DarqSh/kicad_function_generator/falstad_sims/final_10-100Hz_design_v5.txt

<cir f="1" ts="0.00019999999999999998" ic="1.9265835257097934" cb="59" pb="43" vr="5" mts="5e-11">
  <a x="208 96 288 96" f="8" ma="12" mi="-12" ga="100000"/>
  <a x="416 240 496 240" f="8" ma="12" mi="-12" ga="100000"/>
  <c x="272 528 336 528" f="0" c="0.0000015" iv="0.001" sr="0" vd="-1.0300397190273567"/>
  <c x="-16 352 -16 416" f="0" c="0.0000015" iv="0.001" sr="0" vd="0.4276747453221634"/>
  <r x="368 528 464 528" f="0" r="3300"/>
  <r x="48 80 112 80" f="0" r="100"/>
  <r x="224 0 288 0" f="0" r="3300"/>
  <r x="320 96 384 96" f="0" r="3300"/>
  <r x="432 96 496 96" f="0" r="3300"/>
  <r x="416 16 496 16" f="0" r="66000"/>
  <d x="560 16 656 16" f="0" mo="default"/>
  <d x="656 -48 560 -48" f="0" mo="default"/>
  <pt x="-80 80 -16 80" f="1" ma="40000" po="0.005" sl="R_freq_change"/>
  <pt x="560 96 656 96" f="1" ma="1000" po="0.7376" sl="R_feedback_tune"/>
  <g x="176 144 176 192" f="0"/>
  <g x="-16 416 -16 432" f="0"/>
  <w x="-48 64 -48 32" f="0"/>
  <w x="-48 32 16 32" f="0"/>
  <w x="16 32 16 80" f="0"/>
  <w x="-16 80 16 80" f="0"/>
  <w x="16 80 48 80" f="0"/>
  <w x="112 80 176 80" f="0"/>
  <w x="208 112 176 112" f="0"/>
  <w x="176 112 176 144" f="0"/>
  <w x="336 256 416 256" f="0"/>
  <w x="288 96 304 96" f="0"/>
  <w x="384 96 416 96" f="0"/>
  <w x="416 96 432 96" f="0"/>
  <w x="416 224 416 96" f="0"/>
  <w x="288 0 304 0" f="0"/>
  <w x="304 96 320 96" f="0"/>
  <w x="304 0 304 96" f="0"/>
  <w x="224 0 176 0" f="0"/>
  <w x="176 80 208 80" f="0"/>
  <w x="176 0 176 80" f="0"/>
  <w x="416 16 416 96" f="0"/>
  <w x="496 16 512 16" f="0"/>
  <w x="560 -48 512 -48" f="0"/>
  <w x="512 16 560 16" f="0"/>
  <w x="512 -48 512 16" f="0"/>
  <w x="496 96 528 96" f="0"/>
  <w x="656 -48 656 16" f="0"/>
  <w x="656 16 656 96" f="0"/>
  <w x="496 240 656 240" f="0"/>
  <w x="656 240 656 96" f="0"/>
  <w x="-80 80 -80 256" f="0"/>
  <w x="-80 256 -16 256" f="0"/>
  <w x="272 528 -80 528" f="0"/>
  <w x="-80 528 -80 256" f="0"/>
  <w x="336 528 368 528" f="0"/>
  <w x="656 528 656 240" f="0"/>
  <w x="608 80 608 48" f="0"/>
  <w x="608 48 528 48" f="0"/>
  <w x="528 96 560 96" f="0"/>
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
  <a x="1312 288 1424 288" f="8" ma="12" mi="-12" ga="100000"/>
  <g x="1280 320 1280 352" f="0"/>
  <w x="1312 304 1280 304" f="0"/>
  <w x="1280 304 1280 320" f="0"/>
  <w x="1264 272 1312 272" f="0"/>
  <c x="1312 192 1440 192" f="0" c="0.000002" iv="0.001" sr="0" vd="-0.8287330604732464"/>
  <r x="1312 128 1440 128" f="0" r="330000"/>
  <w x="1312 272 1312 192" f="0"/>
  <w x="1312 192 1312 128" f="0"/>
  <w x="1440 128 1440 192" f="0"/>
  <w x="1440 192 1440 288" f="0"/>
  <w x="1424 288 1440 288" f="0"/>
  <a x="928 272 1056 272" f="9" ma="12" mi="-12" ga="100000"/>
  <r x="464 528 656 528" f="0" r="50"/>
  <r x="-16 352 -16 256" f="0" r="50"/>
  <Scope x="1600 -400 2048 -192" f="0">
    <o en="43" sp="8" f="x3" p="-1">
      <p v="0" sc="20"/>
      <p v="3" sc="0.0125"/>
    </o>
  </Scope>
  <w x="-16 256 336 256" f="0"/>
  <Scope x="976 -192 1408 32" f="0">
    <o en="65" sp="1" f="x3" p="-1">
      <p v="0" sc="20"/>
      <p v="3" sc="0.025"/>
    </o>
  </Scope>
  <a x="736 256 832 256" f="8" ma="12" mi="-12" ga="100000"/>
  <w x="656 240 736 240" f="0"/>
  <w x="736 272 736 368" f="0"/>
  <w x="736 368 848 368" f="0"/>
  <r x="848 256 848 368" f="0" r="330000"/>
  <r x="848 368 848 448" f="0" r="33000"/>
  <g x="848 448 848 496" f="0"/>
  <w x="832 256 848 256" f="0"/>
  <w x="928 256 832 256" f="0"/>
  <w x="928 288 928 352" f="0"/>
  <w x="928 352 1056 352" f="0"/>
  <w x="1056 352 1056 272" f="0"/>
  <w x="1440 288 1472 288" f="0"/>
  <c x="1600 304 1696 304" f="0" c="0.000002" iv="0.001" sr="0" vd="-1.2801939105544364"/>
  <w x="1696 304 1696 320" f="0"/>
  <pt x="1696 320 1696 416" f="1" ma="66000" po="0.06440000000000001" sl="triangle_filter_tune"/>
  <g x="1696 416 1696 448" f="0"/>
  <w x="1712 368 1760 368" f="0"/>
  <w x="1760 368 1760 416" f="0"/>
  <w x="1760 416 1696 416" f="0"/>
  <w x="1600 304 1600 384" f="0"/>
  <w x="1472 320 1472 384" f="0"/>
  <a x="1472 304 1600 304" f="9" ma="12" mi="-12" ga="100000"/>
  <w x="1472 384 1600 384" f="0"/>
  <w x="1792 304 1696 304" f="0"/>
  <Scope x="1472 -144 2176 256" f="0">
    <o en="97" sp="2" f="x30403" p="-1">
      <p v="0" sc="10"/>
      <p v="3" sc="0.00009765625"/>
    </o>
  </Scope>
  <w x="1760 576 1808 576" f="0"/>
  <pt x="1744 528 1744 624" f="1" ma="100000" po="0.35150000000000003" sl="DC_choose"/>
  <g x="1616 576 1568 576" f="0"/>
  <v x="1616 576 1616 480" f="16" wf="0" maxv="12"/>
  <v x="1616 672 1616 576" f="16" wf="0" maxv="12"/>
  <w x="1616 480 1744 480" f="0"/>
  <w x="1744 496 1744 528" f="0"/>
  <w x="1744 624 1744 672" f="0"/>
  <w x="1616 672 1744 672" f="0"/>
  <w x="1856 672 1984 672" f="0"/>
  <a x="1856 592 1984 592" f="9" ma="12" mi="-12" ga="100000"/>
  <w x="1856 608 1856 672" f="0"/>
  <w x="1984 592 1984 672" f="0"/>
  <w x="1808 576 1856 576" f="0"/>
  <w x="1984 592 2032 592" f="0"/>
  <r x="2032 592 2144 592" f="0" r="5000"/>
  <w x="1792 400 1920 400" f="0"/>
  <a x="1792 320 1920 320" f="9" ma="12" mi="-12" ga="100000"/>
  <w x="1792 336 1792 352" f="0"/>
  <w x="1920 320 1920 400" f="0"/>
  <w x="1792 352 1792 400" f="0"/>
  <r x="1920 320 2032 320" f="0" r="2500"/>
  <a x="2208 336 2320 336" f="8" ma="12" mi="-12" ga="100000"/>
  <g x="2192 368 2192 400" f="0"/>
  <w x="2192 368 2192 352" f="0"/>
  <w x="2192 352 2208 352" f="0"/>
  <w x="2032 320 2048 320" f="0"/>
  <w x="2144 320 2208 320" f="0"/>
  <w x="2144 592 2144 352" f="0"/>
  <w x="2208 320 2208 256" f="0"/>
  <r x="2208 256 2320 256" f="0" r="5000"/>
  <w x="2320 256 2320 336" f="0"/>
  <Scope x="2240 -80 2720 160" f="0">
    <o en="130" sp="1" f="x20003" p="-1">
      <p v="0" sc="20"/>
      <p v="3" sc="0.003125"/>
    </o>
  </Scope>
  <pt x="1168 272 1264 272" f="1" ma="20000" po="0.0347" sl="triangle_gain"/>
  <r x="1056 272 1152 272" f="0" r="3000"/>
  <w x="1216 256 1216 224" f="0"/>
  <w x="1216 224 1264 224" f="0"/>
  <w x="1264 224 1264 272" f="0"/>
  <pt x="2048 320 2144 320" f="1" ma="50000" po="0.0545" sl="final_output_gain"/>
  <w x="1744 480 1744 496" f="0"/>
  <w x="2144 352 2144 320" f="0"/>
  <w x="2096 304 2096 272" f="0"/>
  <w x="2096 272 2144 272" f="0"/>
  <w x="2144 272 2144 320" f="0"/>
  <r x="1056 224 1152 224" f="0" r="3000"/>
  <w x="1056 272 1056 224" f="0"/>
  <w x="1152 272 1168 272" f="0"/>
  <w x="1152 224 1152 272" f="0"/>
  <o en="43" sp="2" f="x1040a" p="0">
    <p v="0" sc="15.549997616011646"/>
    <p v="3" sc="0.0001"/>
  </o>
  <o en="81" sp="2" f="x28003" p="1">
    <p v="0" sc="20"/>
    <p v="3" sc="0.00009765625"/>
  </o>
</cir>
