DarqSh/kicad_function_generator/function_generator.csv

Reference | Qty | Value | DNP | Exclude from BOM | Exclude from Board | Footprint | Datasheet
C1,C5 | 2 | 1.5nF |  |  |  | capacitor_mine_1p5n:FKP2L011501G00HF00
C2,C6 | 2 | 15nF |  |  |  | capacitor_mine_15n:FKP2F021501L00HSSD
C3,C7 | 2 | 0.15uF |  |  |  | capacitor_mine_150n:R75IF315050H3J
C4,C8 | 2 | 1.5uF |  |  |  | capacitor_mine_1p5u:R75IN415050H4J
C9,C14 | 2 | 22nF |  |  |  | capacitor_mine_22n:B32620__10_x_4_
C10,C16 | 2 | 2.2uF |  |  |  | capacitor_mine_2p2u:890443325010CS
C11,C13 | 2 | 0.22uF |  |  |  | capacitor_mine_220n:B32672__18_x_9_
C12,C15 | 2 | 2.2nF |  |  |  | capacitor_mine_2p2n:B32671L__13_x_5_
C17 | 1 | 22uF |  |  |  | capacitor_mine_22u:CAPAE660X550N
C18,C27,C29,C33,C34,C35,C36,C39,C40,C41,C42,C43,C44,C45,C46,C47,C48 | 17 | 100nF |  |  |  | Capacitor_SMD:C_0805_2012Metric_Pad1.18x1.45mm_HandSolder
C19 | 1 | 47nF |  |  |  | Capacitor_SMD:C_0805_2012Metric_Pad1.18x1.45mm_HandSolder
C20,C22,C25 | 3 | 1uF |  |  |  | Capacitor_SMD:C_0805_2012Metric_Pad1.18x1.45mm_HandSolder
C21 | 1 | 68nF |  |  |  | Capacitor_SMD:C_0805_2012Metric_Pad1.18x1.45mm_HandSolder
C23,C24 | 2 | 10uF |  |  |  | Capacitor_SMD:C_1206_3216Metric_Pad1.33x1.80mm_HandSolder
C26,C28,C30,C31,C32,C37,C38 | 7 | 2.2uF |  |  |  | Capacitor_SMD:C_1206_3216Metric_Pad1.33x1.80mm_HandSolder
D1,D2 | 2 | D |  |  |  | Diode_SMD:D_SOD-123
D3,D7,D8,D9,D10 | 5 | SBA240CH-AU_R1_007A1 |  |  |  | schottky_mine:SBA240CHAU_R1_007A1 | https://www.panjit.com.tw/upload/datasheet/SBA220CH-AU_SERIES.pdf
D4,D5 | 2 | DFLS240-7 |  |  |  | schottky_mine_lowcapacitance:POWERDI123 | https://www.diodes.com//assets/Datasheets/DFLS240.pdf
D6 | 1 | LED |  |  |  | LED_SMD:LED_0805_2012Metric_Pad1.15x1.40mm_HandSolder
F1 | 1 | SF-0402S100M-2 |  |  |  | fuse_my:FUSC1005X61N | https://www.bourns.com/docs/product-datasheets/sf-0402s-m.pdf?sfvrsn=c5e676f6_19
IC1,IC3 | 2 | NE5532AD8R2G |  |  |  | ne5532_onsemi:SOIC127P600X175-8N | https://www.onsemi.com/pub/Collateral/NE5532-D.PDF
IC2,IC4 | 2 | TMUX4052DYYRQ1 |  |  |  | mux_1-to-4:SOP50P326X110-16N | https://www.ti.com/lit/ds/symlink/tmux4052-q1.pdf?ts=1771772113479
IC5 | 1 | TLV1871DDFR |  |  |  | comparator_for_square:SOT65P280X110-8N | https://www.ti.com/product/TLV1871/part-details/TLV1871DDFR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
IC8 | 1 | ADP5070AREZ |  |  |  | adp5070:SOP65P640X120-21N | https://www.analog.com/media/en/technical-documentation/data-sheets/adp5070.pdf
IC9,IC11 | 2 | ADP7142AUJZ-R7 |  |  |  | ldo_positive:SOT95P280X100-5N | https://www.analog.com/ADP7142/datasheet
IC10,IC12 | 2 | ADP7182AUJZ-R7 |  |  |  | ldo_negative:SOT95P280X100-5N | http://www.analog.com/media/en/technical-documentation/data-sheets/ADP7182.pdf
IC13 | 1 | OPA1656IDR |  |  |  | opa1656_mine:SOIC127P600X175-8N | http://www.ti.com/lit/gpn/OPA1656
J1 | 1 | barrel_jack |  |  |  | barrel_jack_connector:694106301002 | https://www.we-online.com/catalog/datasheet/694106301002.pdf
J2,J3 | 2 | 571-0500 |  |  |  | banana_socket:5710500 | https://componentsearchengine.com/Datasheets/1/571-0500.pdf
L1 | 1 | 6.8uH |  |  |  | inductor_mine_positive:XAL6060682MEC
L2 | 1 | 15uH |  |  |  | inductor_mine_negative:XAL6060153MEC
R1,R4,R5,R6 | 4 | 3.3k |  |  |  | Resistor_SMD:R_0805_2012Metric_Pad1.20x1.40mm_HandSolder
R2,R14,R32,R33,R35 | 5 | 10k |  |  |  | Resistor_SMD:R_0805_2012Metric_Pad1.20x1.40mm_HandSolder
R3 | 1 | 300 |  |  |  | Resistor_SMD:R_0805_2012Metric_Pad1.20x1.40mm_HandSolder
R7 | 1 | 64.9k |  |  |  | Resistor_SMD:R_0805_2012Metric_Pad1.20x1.40mm_HandSolder
R8,R34 | 2 | 5k |  |  |  | Resistor_SMD:R_0805_2012Metric_Pad1.20x1.40mm_HandSolder
R9,R10 | 2 | 3.9k |  |  |  | Resistor_SMD:R_0805_2012Metric_Pad1.20x1.40mm_HandSolder
R11,R19,R29 | 3 | 100k |  |  |  | Resistor_SMD:R_0805_2012Metric_Pad1.20x1.40mm_HandSolder
R12 | 1 | 330k |  |  |  | Resistor_SMD:R_0805_2012Metric_Pad1.20x1.40mm_HandSolder
R13,R16,R27 | 3 | 15k |  |  |  | Resistor_SMD:R_0805_2012Metric_Pad1.20x1.40mm_HandSolder
R15 | 1 | 12k |  |  |  | Resistor_SMD:R_0805_2012Metric_Pad1.20x1.40mm_HandSolder
R17 | 1 | 2.15M |  |  |  | Resistor_SMD:R_0805_2012Metric_Pad1.20x1.40mm_HandSolder
R18 | 1 | 113k |  |  |  | Resistor_SMD:R_0805_2012Metric_Pad1.20x1.40mm_HandSolder
R20 | 1 | 2.1M |  |  |  | Resistor_SMD:R_0805_2012Metric_Pad1.20x1.40mm_HandSolder
R21,R24 | 2 | 52.3k |  |  |  | Resistor_SMD:R_0805_2012Metric_Pad1.20x1.40mm_HandSolder
R22,R23,R25,R26 | 4 | 4.64k |  |  |  | Resistor_SMD:R_0805_2012Metric_Pad1.20x1.40mm_HandSolder
R28 | 1 | 102k |  |  |  | Resistor_SMD:R_0805_2012Metric_Pad1.20x1.40mm_HandSolder
R30,R31 | 2 | 11.5k |  |  |  | Resistor_SMD:R_0805_2012Metric_Pad1.20x1.40mm_HandSolder
S1,S2 | 2 | ASLB1470 |  |  |  | slide_switch_sp4t:ASLB1470 | https://www.apem.com/idec-apem/en_US/medias/APEM-Miniature-slide-switches-ASLB.pdf
VR1,VR6 | 2 | 100k |  |  |  | pot_100k_linear:PTN091V100115K1B | https://www.sameskydevices.com/product/resource/ptn09x.pdf
VR2 | 1 | 1k |  |  |  | pot_1k_feedbacktune:PTN091V01115K1B | https://www.sameskydevices.com/product/resource/ptn09x.pdf
VR3 | 1 | 20k |  |  |  | pot_20k:PTN091V20115K1B | https://www.sameskydevices.com/product/resource/ptn09x.pdf
VR4 | 1 | 100k_log |  |  |  | pot_100k_log:PTN091V100115K1A | https://www.sameskydevices.com/product/resource/ptn09x.pdf
VR5 | 1 | 20k dual-gang |  |  |  | pot_20k_dualgang:P140KH1Y20AR20K | https://www.ttelectronics.com/TTElectronics/media/ProductFiles/Datasheet/P140.pdf
