DarqSh/kicad_function_generator/production/bom.csv

Designator | Footprint | Quantity | Value | LCSC Part #
C1, C5 | 1210 | 2 | 1.5nF
C10, C16 | 890443325010CS | 2 | 2.2uF
C11, C13 | 1206 | 2 | 0.22uF
C12, C15 | 0805 | 2 | 2.2nF
C14, C9 | 0805 | 2 | 22nF
C17 | CAPAE660X550N | 1 | 22uF
C18, C27, C29, C33, C34, C35, C36, C39, C40, C41, C42, C43, C44, C45, C46, C47, C48 | 0805 | 17 | 100nF
C19 | 0805 | 1 | 47nF
C2, C6 | 0805 | 2 | 15nF
C20, C22, C25 | 0805 | 3 | 1uF
C21 | 0805 | 1 | 68nF
C23, C24 | 1206 | 2 | 10uF
C26, C28, C30, C31, C32, C37, C38 | 1206 | 7 | 2.2uF
C3, C7 | 1206 | 2 | 0.15uF
C4, C8 | R75IN415050H4J | 2 | 1.5uF
D1, D2 | D_SOD-123 | 2 | D
D10, D3, D7, D8, D9 | SBA240CHAU_R1_007A1 | 5 | SBA240CH-AU_R1_007A1
D4, D5 | POWERDI123 | 2 | DFLS240-7
D6 | 0805 | 1 | LED
F1 | FUSC3215X66N | 1 | 0466001.NR
IC1, IC3 | SOIC127P600X175-8N | 2 | NE5532AD8R2G
IC10, IC12 | SOT95P280X100-5N | 2 | ADP7182AUJZ-R7
IC11, IC9 | SOT95P280X100-5N | 2 | ADP7142AUJZ-R7
IC2, IC4 | SOP50P326X110-16N | 2 | TMUX4052DYYRQ1
IC5 | SOT65P280X110-8N | 1 | TLV1871DDFR
IC6 | SOIC127P600X175-8N | 1 | OPA1656IDR
IC8 | SOP65P640X120-21N | 1 | ADP5070AREZ
J1 | 694106301002 | 1 | barrel_jack
J2 | 5710500 | 1 | 571-0500
J3 | 5710300 | 1 | 571-0300
L1 | XAL6060682MEC | 1 | 6.8uH
L2 | XAL6060153MEC | 1 | 15uH
R1, R4, R5, R6 | 0805 | 4 | 3.3k
R10, R9 | 0805 | 2 | 3.9k
R11, R19, R29 | 0805 | 3 | 100k
R12 | 0805 | 1 | 330k
R13, R16, R27 | 0805 | 3 | 15k
R14, R2, R32, R33, R35 | 0805 | 5 | 10k
R15 | 0805 | 1 | 12k
R17 | 0805 | 1 | 2.15M
R18 | 0805 | 1 | 113k
R20 | 0805 | 1 | 2.1M
R21, R24 | 0805 | 2 | 52.3k
R22, R23, R25, R26 | 0805 | 4 | 4.64k
R28 | 0805 | 1 | 102k
R3 | 0805 | 1 | 300
R30, R31 | 0805 | 2 | 11.5k
R34 | 0805 | 1 | 4.99k
R7 | 0805 | 1 | 64.9k
R8 | 0805 | 1 | 5k
S1, S2 | ASLB1470 | 2 | ASLB1470
VR1, VR6 | PTN091V100115K1B | 2 | 100k
VR2 | PTN091V01115K1B | 1 | 1k
VR3 | PTN091V20115K1B | 1 | 20k
VR4 | PTN091V100115K1A | 1 | 100k_log
VR5 | P140KH1Y20AR20K | 1 | 20k dual-gang
