DarqSh/kicad_function_generator/function_generator.step

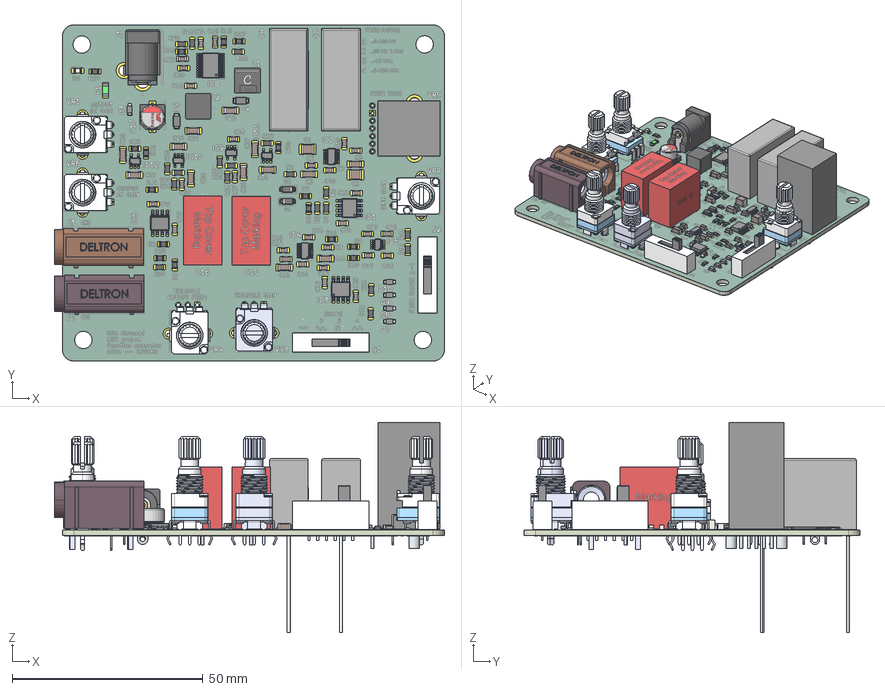
[picture p1: CAD file, 2026-11-08]
function_generator.step
102.2 x 88.1 x 55.1 mm
capicitor_6.3x5.5x2.2
Base_Φ6_3Capacitor
PinsArrayLR x 5
C_0805_2012Metric x 28
CFR_RB2_26.5X18.5X10_L26.8H18.6T10.2S22.5LL27F0.85 x 2
PinsArrayL x 4
PinsArrayR x 4
Leads
FIX_PLATE x 5
BUSHING_5-V_V1 x 5
PTN091-V_HOUSING x 5
K_SHAFT_L15 x 5
XAL6060-153MEC
R_0805_2012Metric x 35
Pins x 5
C_1206_3216Metric x 13
LED_0805_2012Metric
term1
term2
C_1210_3225Metric x 2
DFLS240-7 x 2
ASLB1470 x 2
ThermalPad
D_SOD-123 x 2
6941xx301002
694106301002_PinContact
6941xx301002_Back
6941xx301002_PinContact2
6941xx301002_PinLame
6941xx301002_PinBis
XAL6060-682MEC
LM74701QDDFRQ1
BODY-SO
LEAD-D0008A x 8
function_generator-unsaved-export-jNfYIj_copper
function_generator-unsaved-export-jNfYIj_silkscreen x 2
function_generator-unsaved-export-jNfYIj_soldermask x 2
function_generator-unsaved-export-jNfYIj_PCB
