DarqSh/kicad_function_generator/(list of files, cad)

Other CAD files:
3dmodel2.step
