DarqSh/kicad_function_generator/_restore_backup_2026-11-08T17-53-06-923/function_generator.kicad_pcb

## KiCad design _restore_backup_2026-11-08T17-53-06-923/function_generator.kicad_pcb (2026-11-08)

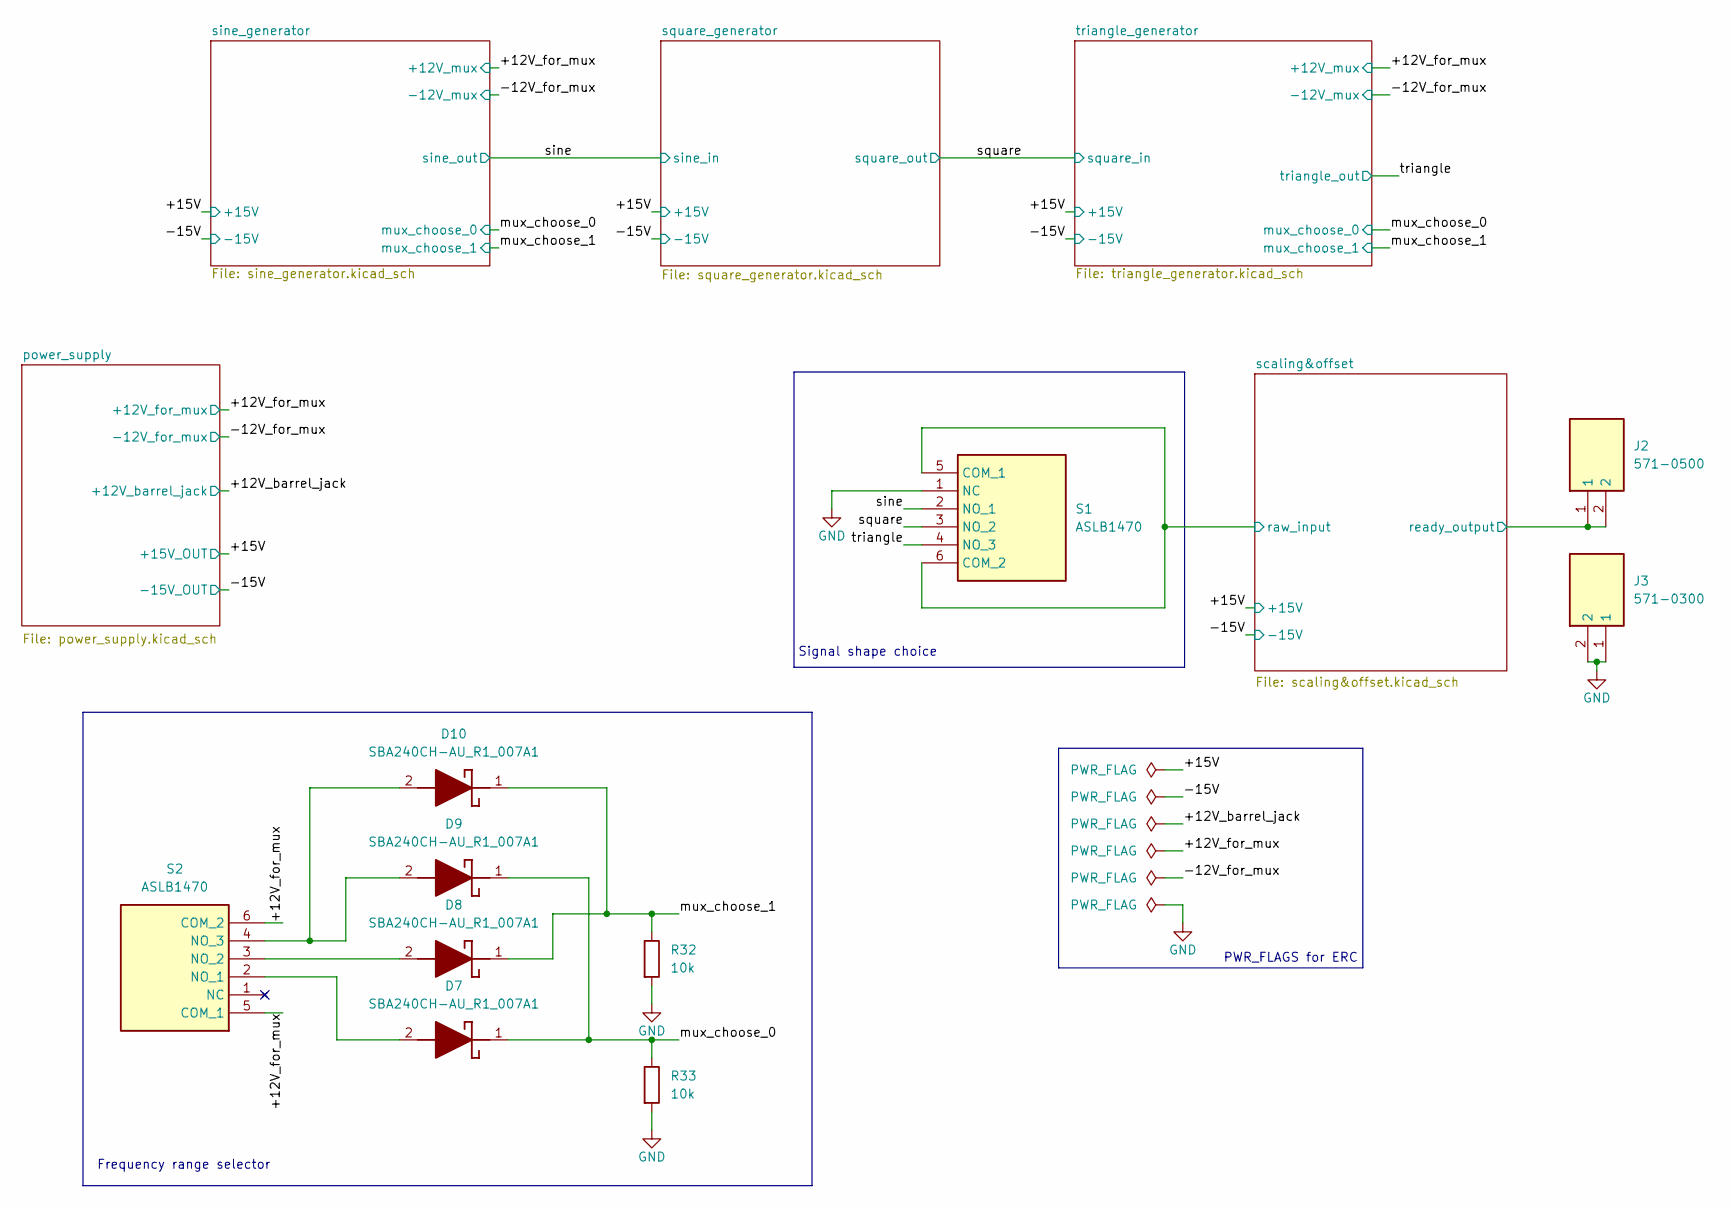
[picture p2: schematic function_generator.kicad_sch, Function generator]

Parts:
D7, D8, D9, D10: SBA240CH-AU_R1_007A1; SBA240CHAU_R1_007A1; Manufacturer_Part_Number SBA240CH-AU_R1_007A1
J2: 571-0500; 5710500; Mouser Part Number 164-6219
J3: 571-0300; 5710300; Mouser Part Number 164-7130
R32, R33: 10k; R_0805_2012Metric_Pad1.20x1.40mm_HandSolder
S1, S2: ASLB1470; Mouser Part Number 642-ASLB1470

Connections:
/+12V_for_mux: S2.5 (COM_1), S2.6 (COM_2); also elsewhere on the board
/mux_choose_0: D7.1 (K), D9.1 (K), R33.1; also elsewhere on the board
/mux_choose_1: D8.1 (K), D10.1 (K), R32.1; also elsewhere on the board
/scaling&offset/raw_input: S1.5 (COM_1), S1.6 (COM_2); also elsewhere on the board
/scaling&offset/ready_output: J2.1, J2.2; also elsewhere on the board
/sine: S1.2 (NO_1); also elsewhere on the board
/square: S1.3 (NO_2); also elsewhere on the board
/triangle: S1.4 (NO_3); also elsewhere on the board
GND: J3.1, J3.2, R32.2, R33.2, S1.1 (NC); also elsewhere on the board
unnamed: D7.2 (A), S2.2 (NO_1)
unnamed: D8.2 (A), S2.3 (NO_2)
unnamed: D9.2 (A), D10.2 (A), S2.4 (NO_3)

Notes on the sheet:
Signal shape choice
Frequency range selector
PWR_FLAGS for ERC

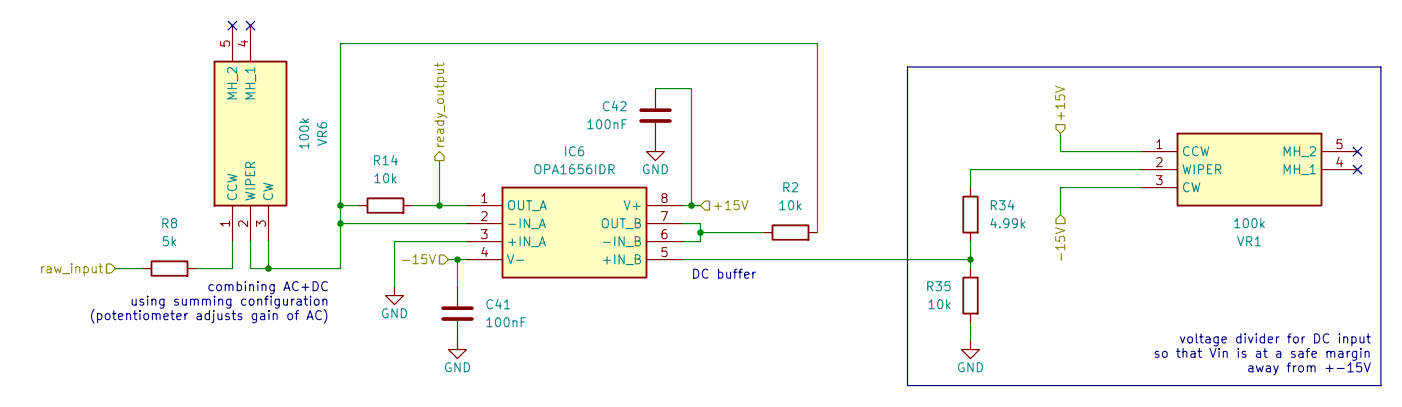
[picture p3: schematic scaling&offset.kicad_sch]

Parts:
C41, C42: 100nF; C_0805_2012Metric_Pad1.18x1.45mm_HandSolder
IC6: OPA1656IDR; SOIC127P600X175-8N; Mouser Part Number 595-OPA1656IDR
R2, R14, R35: 10k; R_0805_2012Metric_Pad1.20x1.40mm_HandSolder
R8: 5k; R_0805_2012Metric_Pad1.20x1.40mm_HandSolder
R34: 4.99k; R_0805_2012Metric_Pad1.20x1.40mm_HandSolder
VR1, VR6: 100k; PTN091V100115K1B; Manufacturer_Part_Number PTN091-V100115K1B

Connections:
/+15V: C42.1, IC6.8 (V+), VR1.1 (CCW); also elsewhere on the board
/-15V: C41.1, IC6.4 (V-), VR1.3 (CW); also elsewhere on the board
/scaling&offset/raw_input: R8.1; also elsewhere on the board
/scaling&offset/ready_output: IC6.1 (OUT_A), R14.2; also elsewhere on the board
GND: C41.2, C42.2, IC6.3 (+IN_A), R35.2; also elsewhere on the board
unnamed: IC6.5 (+IN_B), R34.2, R35.1
unnamed: IC6.2 (-IN_A), R2.2, R14.1, VR6.2 (WIPER), VR6.3 (CW)
unnamed: IC6.6 (-IN_B), IC6.7 (OUT_B), R2.1
unnamed: R34.1, VR1.2 (WIPER)
unnamed: R8.2, VR6.1 (CCW)

Notes on the sheet:
DC buffer
combining AC+DC using summing configuration (potentiometer adjusts gain of AC)
voltage divider for DC input so that Vin is at a safe margin away from +-15V

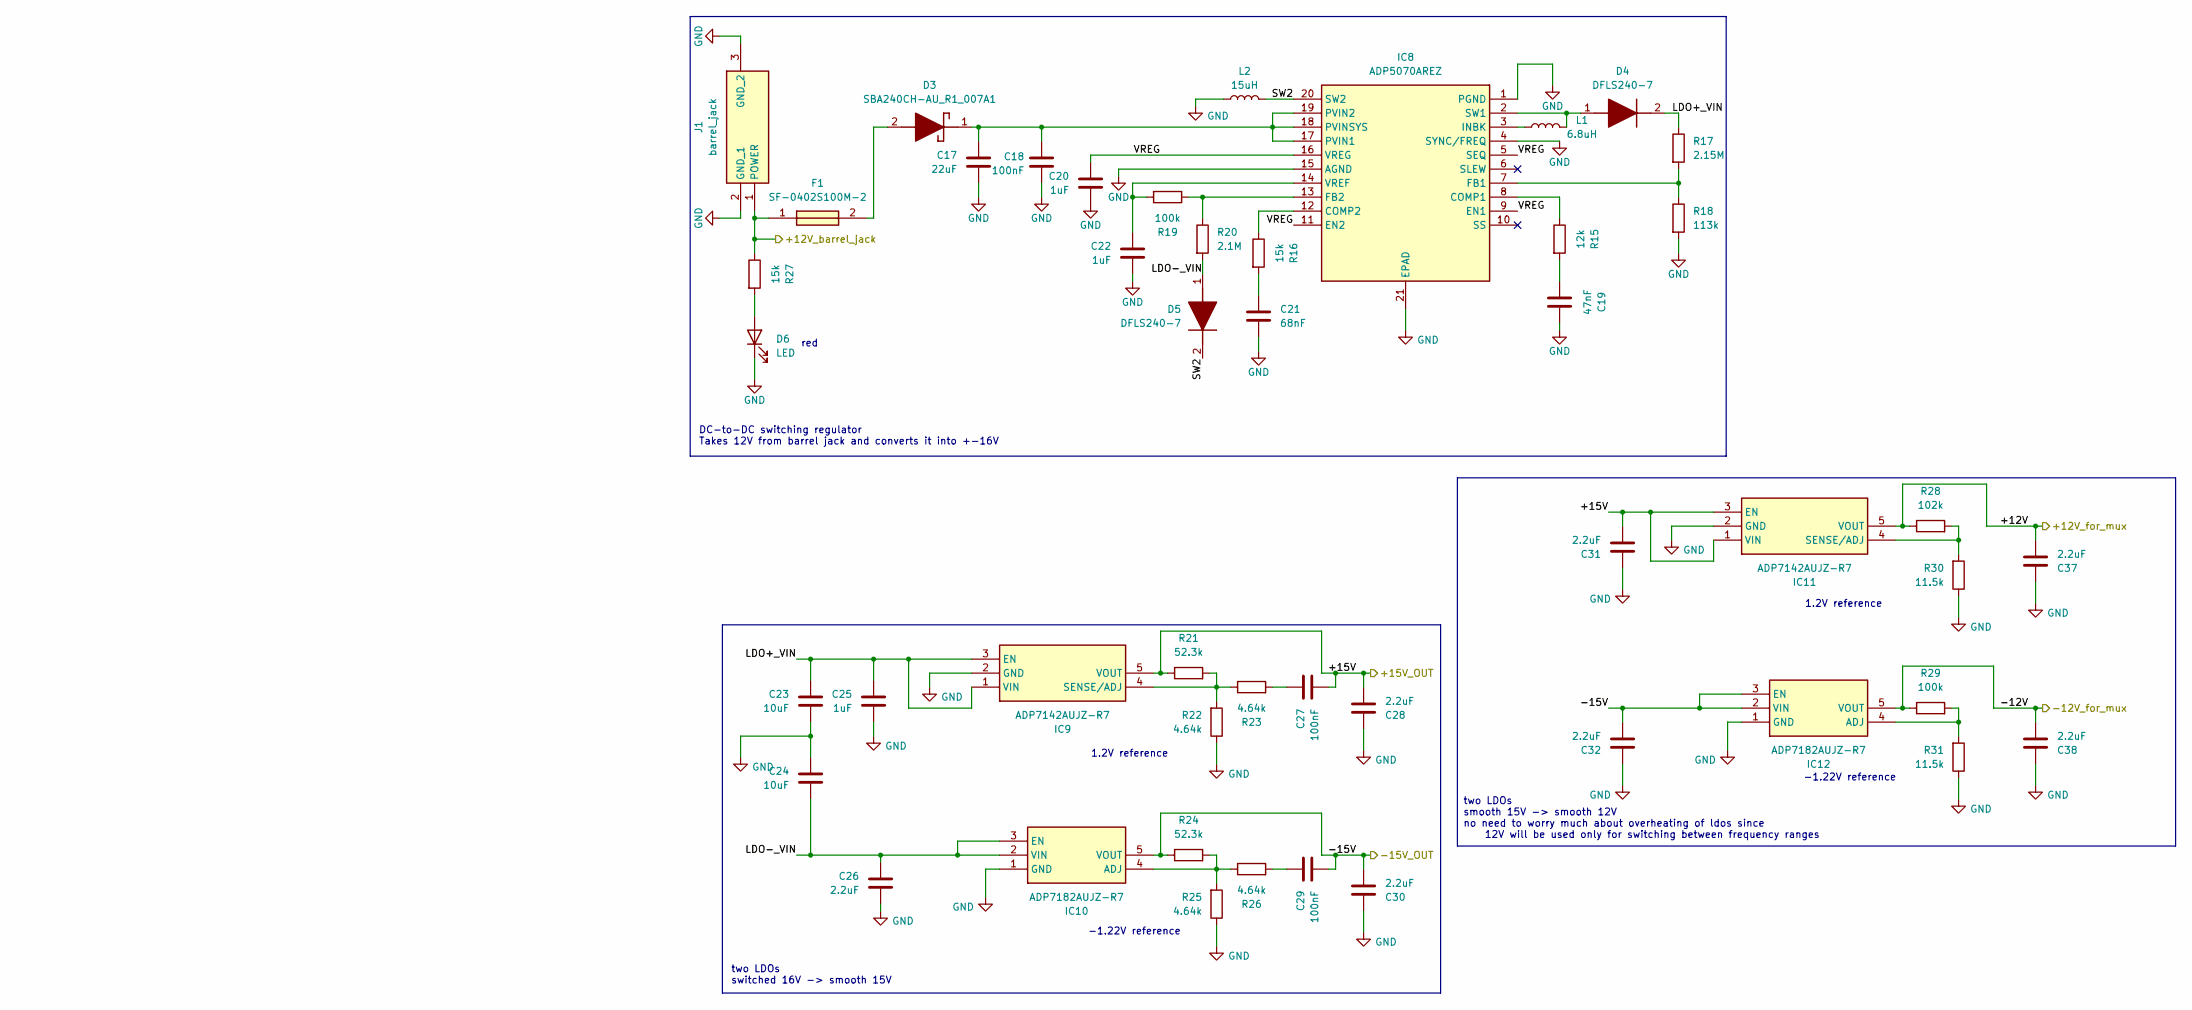
[picture p4: schematic power_supply.kicad_sch, part in row 1, column 2]

Parts:
C17: 22uF; CAPAE660X550N
C18, C27, C29: 100nF; C_0805_2012Metric_Pad1.18x1.45mm_HandSolder
C19: 47nF; C_0805_2012Metric_Pad1.18x1.45mm_HandSolder
C20, C22, C25: 1uF; C_0805_2012Metric_Pad1.18x1.45mm_HandSolder
C21: 68nF; C_0805_2012Metric_Pad1.18x1.45mm_HandSolder
C23, C24: 10uF; C_1206_3216Metric_Pad1.33x1.80mm_HandSolder
C26, C28, C30, C31, C32, C37, C38: 2.2uF; C_1206_3216Metric_Pad1.33x1.80mm_HandSolder
D3: SBA240CH-AU_R1_007A1; SBA240CHAU_R1_007A1; Manufacturer_Part_Number SBA240CH-AU_R1_007A1
D4, D5: DFLS240-7; POWERDI123; Mouser Part Number 621-DFLS240-7
D6: LED; LED_0805_2012Metric_Pad1.15x1.40mm_HandSolder
F1: SF-0402S100M-2; Fuse_1206_3216Metric_Pad1.42x1.75mm_HandSolder; Mouser Part Number 652-SF-0402S100M-2
IC8: ADP5070AREZ; SOP65P640X120-21N; Mouser Part Number 584-ADP5070AREZ
IC9, IC11: ADP7142AUJZ-R7; SOT95P280X100-5N; Mouser Part Number 584-ADP7142AUJZ-R7
IC10, IC12: ADP7182AUJZ-R7; SOT95P280X100-5N; Mouser Part Number 584-ADP7182AUJZ-R7
J1: barrel_jack; 694106301002; Mouser Part Number 710-694106301002
L1: 6.8uH; XAL6060682MEC
L2: 15uH; XAL6060153MEC
R15: 12k; R_0805_2012Metric_Pad1.20x1.40mm_HandSolder
R16, R27: 15k; R_0805_2012Metric_Pad1.20x1.40mm_HandSolder
R17: 2.15M; R_0805_2012Metric_Pad1.20x1.40mm_HandSolder
R18: 113k; R_0805_2012Metric_Pad1.20x1.40mm_HandSolder
R19, R29: 100k; R_0805_2012Metric_Pad1.20x1.40mm_HandSolder
R20: 2.1M; R_0805_2012Metric_Pad1.20x1.40mm_HandSolder
R21, R24: 52.3k; R_0805_2012Metric_Pad1.20x1.40mm_HandSolder
R22, R23, R25, R26: 4.64k; R_0805_2012Metric_Pad1.20x1.40mm_HandSolder
R28: 102k; R_0805_2012Metric_Pad1.20x1.40mm_HandSolder
R30, R31: 11.5k; R_0805_2012Metric_Pad1.20x1.40mm_HandSolder

Connections:
/+12V_barrel_jack: F1.1, J1.1 (POWER), R27.1
/+12V_for_mux: C37.2, IC11.5 (VOUT), R28.1; also elsewhere on the board
/+15V: C27.2, C28.2, C31.2, IC9.5 (VOUT), IC11.1 (VIN), IC11.3 (EN), R21.1; also elsewhere on the board
/-12V_for_mux: C38.2, IC12.5 (VOUT), R29.1; also elsewhere on the board
/-15V: C29.2, C30.2, C32.2, IC10.5 (VOUT), IC12.2 (VIN), IC12.3 (EN), R24.1; also elsewhere on the board
/power_supply/LDO+_VIN: C23.1, C25.1, D4.2 (K), IC9.1 (VIN), IC9.3 (EN), R17.1
/power_supply/LDO-_VIN: C24.2, C26.1, D5.1 (A), IC10.2 (VIN), IC10.3 (EN), R20.2
/power_supply/SW2: D5.2 (K), IC8.20 (SW2), L2.2
/power_supply/VREG: C20.1, IC8.5 (SEQ), IC8.9 (EN1), IC8.11 (EN2), IC8.16 (VREG)
GND: C17.2, C18.2, C19.2, C20.2, C21.2, C22.2, C23.2, C24.1, C25.2, C26.2, C28.1, C30.1, C31.1, C32.1, C37.1, C38.1, D6.1 (K), IC8.1 (PGND), IC8.4 (SYNC/FREQ), IC8.15 (AGND), IC8.21 (EPAD), IC9.2 (GND), IC10.1 (GND), IC11.2 (GND), IC12.1 (GND), J1.2 (GND_1), J1.3 (GND_2), L2.1, R18.2, R22.1, R25.1, R30.1, R31.1; also elsewhere on the board
unnamed: C19.1, R15.2
unnamed: C21.1, R16.2
unnamed: C27.1, R23.2
unnamed: C29.1, R26.2
unnamed: D3.2 (A), F1.2
unnamed: C17.1, C18.1, D3.1 (K), IC8.17 (PVIN1), IC8.18 (PVINSYS), IC8.19 (PVIN2)
unnamed: D4.1 (A), IC8.2 (SW1), L1.2
unnamed: D6.2 (A), R27.2
unnamed: IC8.8 (COMP1), R15.1
unnamed: IC8.12 (COMP2), R16.1
unnamed: IC8.7 (FB1), R17.2, R18.1
unnamed: IC8.13 (FB2), R19.2, R20.1
unnamed: IC8.3 (INBK), L1.1
unnamed: C22.1, IC8.14 (VREF), R19.1
unnamed: IC9.4 (SENSE/ADJ), R21.2, R22.2, R23.1
unnamed: IC10.4 (ADJ), R24.2, R25.2, R26.1
unnamed: IC11.4 (SENSE/ADJ), R28.2, R30.2
unnamed: IC12.4 (ADJ), R29.2, R31.2

Notes on the sheet:
1.2V reference
two LDOs smooth 15V -> smooth 12V no need to worry much about overheating of ldos since 12V will be used only for switching between frequency ranges
-1.22V reference
red
DC-to-DC switching regulator Takes 12V from barrel jack and converts it into +-16V
two LDOs switched 16V -> smooth 15V

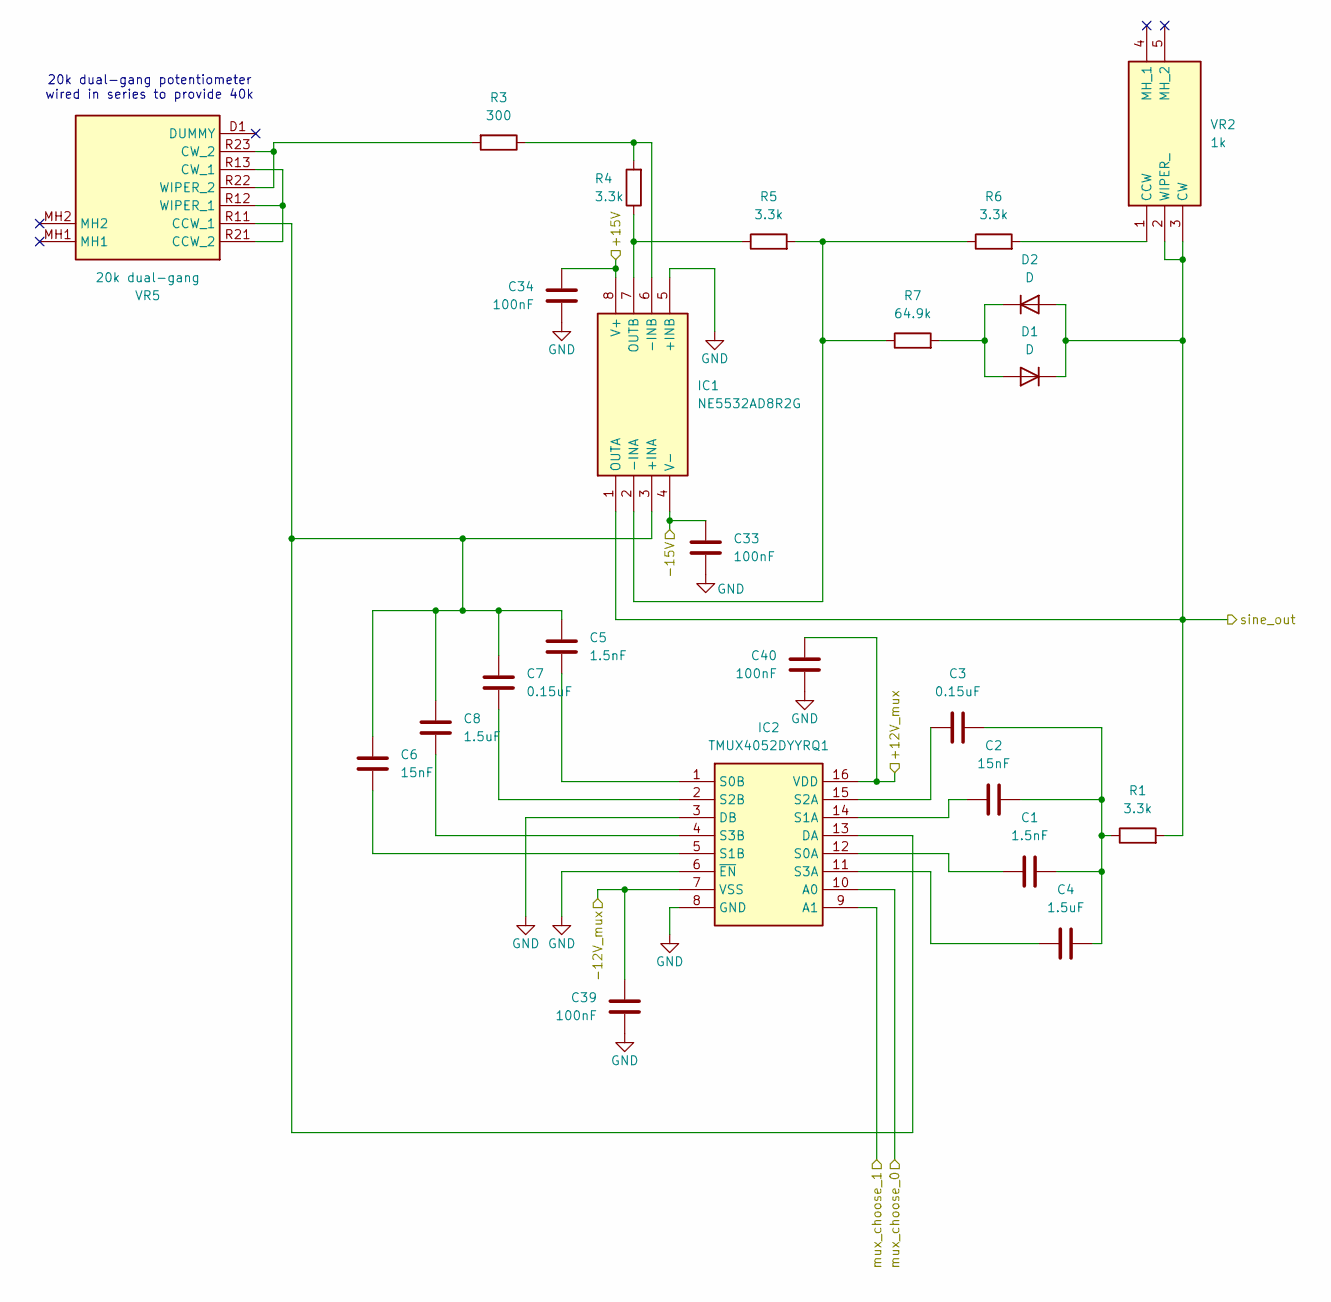
[picture p5: schematic sine_generator.kicad_sch]

Parts:
C1, C5: 1.5nF; C_1210_3225Metric_Pad1.33x2.70mm_HandSolder
C2, C6: 15nF; C_0805_2012Metric_Pad1.18x1.45mm_HandSolder
C3, C7: 0.15uF; C_1206_3216Metric_Pad1.33x1.80mm_HandSolder
C4, C8: 1.5uF; R75IN415050H4J
C33, C34, C39, C40: 100nF; C_0805_2012Metric_Pad1.18x1.45mm_HandSolder
D1, D2: D; D_SOD-123
IC1: NE5532AD8R2G; SOIC127P600X175-8N; Mouser Part Number 863-NE5532AD8R2G
IC2: TMUX4052DYYRQ1; SOP50P326X110-16N; Mouser Part Number 595-TMUX4052DYYRQ1
R1, R4, R5, R6: 3.3k; R_0805_2012Metric_Pad1.20x1.40mm_HandSolder
R3: 300; R_0805_2012Metric_Pad1.20x1.40mm_HandSolder
R7: 64.9k; R_0805_2012Metric_Pad1.20x1.40mm_HandSolder
VR2: 1k; PTN091V01115K1B; Manufacturer_Part_Number PTN091-V01115K1B
VR5: 20k dual-gang; P140KH1Y20AR20K; Mouser Part Number 858-P140KH1-20AR20K

Connections:
/+12V_for_mux: C40.1, IC2.16 (VDD); also elsewhere on the board
/+15V: C34.1, IC1.8 (V+); also elsewhere on the board
/-12V_for_mux: C39.1, IC2.7 (VSS); also elsewhere on the board
/-15V: C33.1, IC1.4 (V-); also elsewhere on the board
/mux_choose_0: IC2.10 (A0); also elsewhere on the board
/mux_choose_1: IC2.9 (A1); also elsewhere on the board
/sine: D1.1 (K), D2.2 (A), IC1.1 (OUTA), R1.2, VR2.2 (WIPER_), VR2.3 (CW); also elsewhere on the board
GND: C33.2, C34.2, C39.2, C40.2, IC1.5 (+INB), IC2.3 (DB), IC2.6 (~EN), IC2.8 (GND); also elsewhere on the board
unnamed: C1.2, C2.2, C3.2, C4.2, R1.1
unnamed: D1.2 (A), D2.1 (K), R7.2
unnamed: C5.1, C6.1, C7.1, C8.1, IC1.3 (+INA), IC2.13 (DA), VR5.R11 (CCW_1)
unnamed: IC1.2 (-INA), R5.2, R6.1, R7.1
unnamed: IC1.6 (-INB), R3.1, R4.2
unnamed: IC1.7 (OUTB), R4.1, R5.1
unnamed: C1.1, IC2.12 (S0A)
unnamed: C5.2, IC2.1 (S0B)
unnamed: C2.1, IC2.14 (S1A)
unnamed: C6.2, IC2.5 (S1B)
unnamed: C3.1, IC2.15 (S2A)
unnamed: C7.2, IC2.2 (S2B)
unnamed: C4.1, IC2.11 (S3A)
unnamed: C8.2, IC2.4 (S3B)
unnamed: R6.2, VR2.1 (CCW)
unnamed: VR5.R12 (WIPER_1), VR5.R13 (CW_1), VR5.R21 (CCW_2)
unnamed: R3.2, VR5.R22 (WIPER_2), VR5.R23 (CW_2)

Notes on the sheet:
20k dual-gang potentiometer wired in series to provide 40k

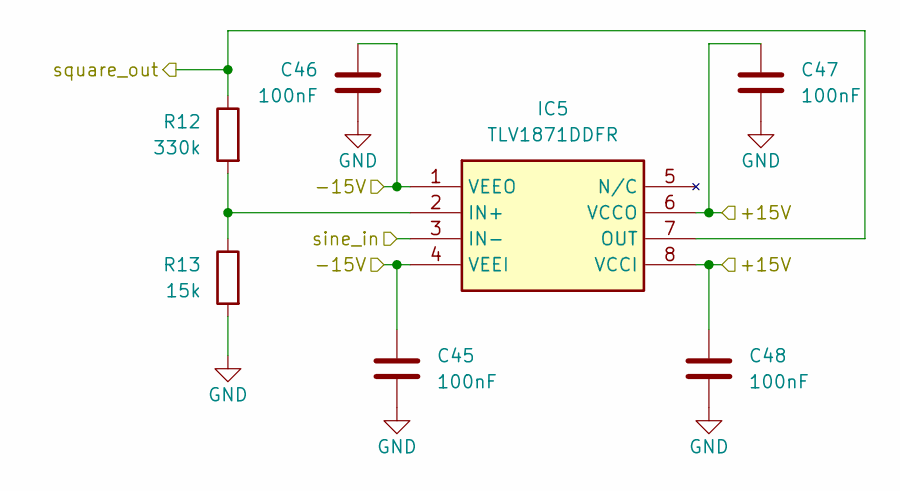
[picture p6: schematic square_generator.kicad_sch]

Parts:
C45, C46, C47, C48: 100nF; C_0805_2012Metric_Pad1.18x1.45mm_HandSolder
IC5: TLV1871DDFR; SOT65P280X110-8N; Mouser Part Number 595-TLV1871DDFR
R12: 330k; R_0805_2012Metric_Pad1.20x1.40mm_HandSolder
R13: 15k; R_0805_2012Metric_Pad1.20x1.40mm_HandSolder

Connections:
/+15V: C47.1, C48.1, IC5.6 (VCCO), IC5.8 (VCCI); also elsewhere on the board
/-15V: C45.1, C46.1, IC5.1 (VEEO), IC5.4 (VEEI); also elsewhere on the board
/sine: IC5.3 (IN-); also elsewhere on the board
/square: IC5.7 (OUT), R12.1; also elsewhere on the board
GND: C45.2, C46.2, C47.2, C48.2, R13.2; also elsewhere on the board
unnamed: IC5.2 (IN+), R12.2, R13.1

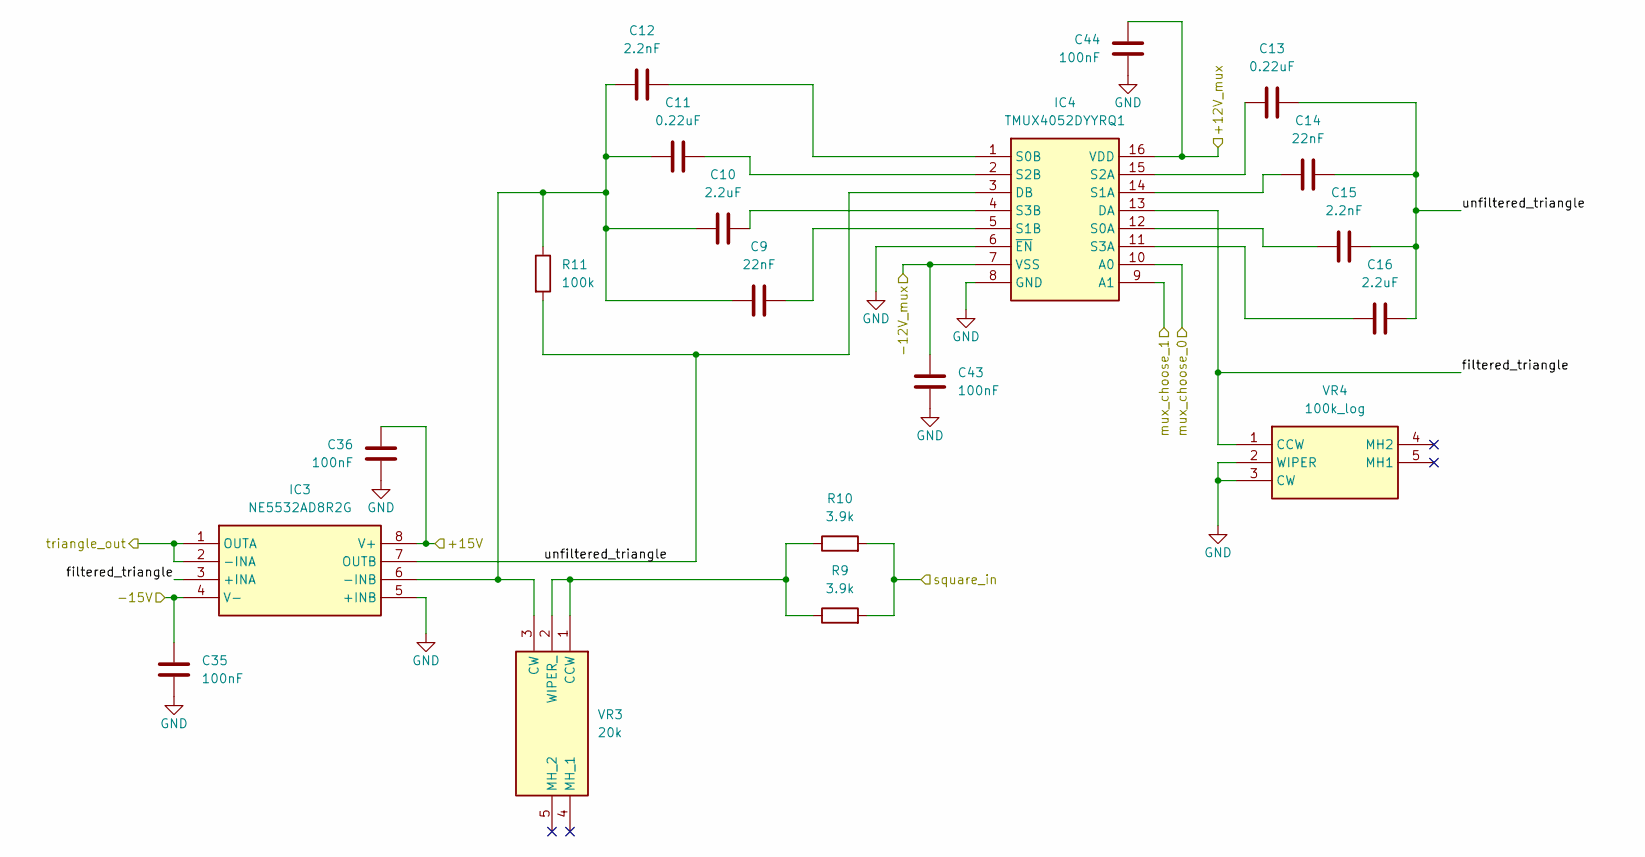
[picture p7: schematic triangle_generator.kicad_sch]

Parts:
C9, C14: 22nF; C_0805_2012Metric_Pad1.18x1.45mm_HandSolder
C10, C16: 2.2uF; 890443325010CS
C11, C13: 0.22uF; C_1206_3216Metric_Pad1.33x1.80mm_HandSolder
C12, C15: 2.2nF; C_0805_2012Metric_Pad1.18x1.45mm_HandSolder
C35, C36, C43, C44: 100nF; C_0805_2012Metric_Pad1.18x1.45mm_HandSolder
IC3: NE5532AD8R2G; SOIC127P600X175-8N; Mouser Part Number 863-NE5532AD8R2G
IC4: TMUX4052DYYRQ1; SOP50P326X110-16N; Mouser Part Number 595-TMUX4052DYYRQ1
R9, R10: 3.9k; R_0805_2012Metric_Pad1.20x1.40mm_HandSolder
R11: 100k; R_0805_2012Metric_Pad1.20x1.40mm_HandSolder
VR3: 20k; PTN091V20115K1B; Manufacturer_Part_Number PTN091-V20115K1B
VR4: 100k_log; PTN091V100115K1A; Manufacturer_Part_Number PTN091-V100115K1A

Connections:
/+12V_for_mux: C44.1, IC4.16 (VDD); also elsewhere on the board
/+15V: C36.1, IC3.8 (V+); also elsewhere on the board
/-12V_for_mux: C43.1, IC4.7 (VSS); also elsewhere on the board
/-15V: C35.1, IC3.4 (V-); also elsewhere on the board
/mux_choose_0: IC4.10 (A0); also elsewhere on the board
/mux_choose_1: IC4.9 (A1); also elsewhere on the board
/square: R9.2, R10.2; also elsewhere on the board
/triangle: IC3.1 (OUTA), IC3.2 (-INA); also elsewhere on the board
/triangle_generator/filtered_triangle: IC3.3 (+INA), IC4.13 (DA), VR4.1 (CCW)
/triangle_generator/unfiltered_triangle: C13.2, C14.2, C15.2, C16.2, IC3.7 (OUTB), IC4.3 (DB), R11.2
GND: C35.2, C36.2, C43.2, C44.2, IC3.5 (+INB), IC4.6 (~EN), IC4.8 (GND), VR4.2 (WIPER), VR4.3 (CW); also elsewhere on the board
unnamed: C9.2, C10.2, C11.1, C12.1, IC3.6 (-INB), R11.1, VR3.3 (CW)
unnamed: C15.1, IC4.12 (S0A)
unnamed: C12.2, IC4.1 (S0B)
unnamed: C14.1, IC4.14 (S1A)
unnamed: C9.1, IC4.5 (S1B)
unnamed: C13.1, IC4.15 (S2A)
unnamed: C11.2, IC4.2 (S2B)
unnamed: C16.1, IC4.11 (S3A)
unnamed: C10.1, IC4.4 (S3B)
unnamed: R9.1, R10.1, VR3.1 (CCW), VR3.2 (WIPER_)

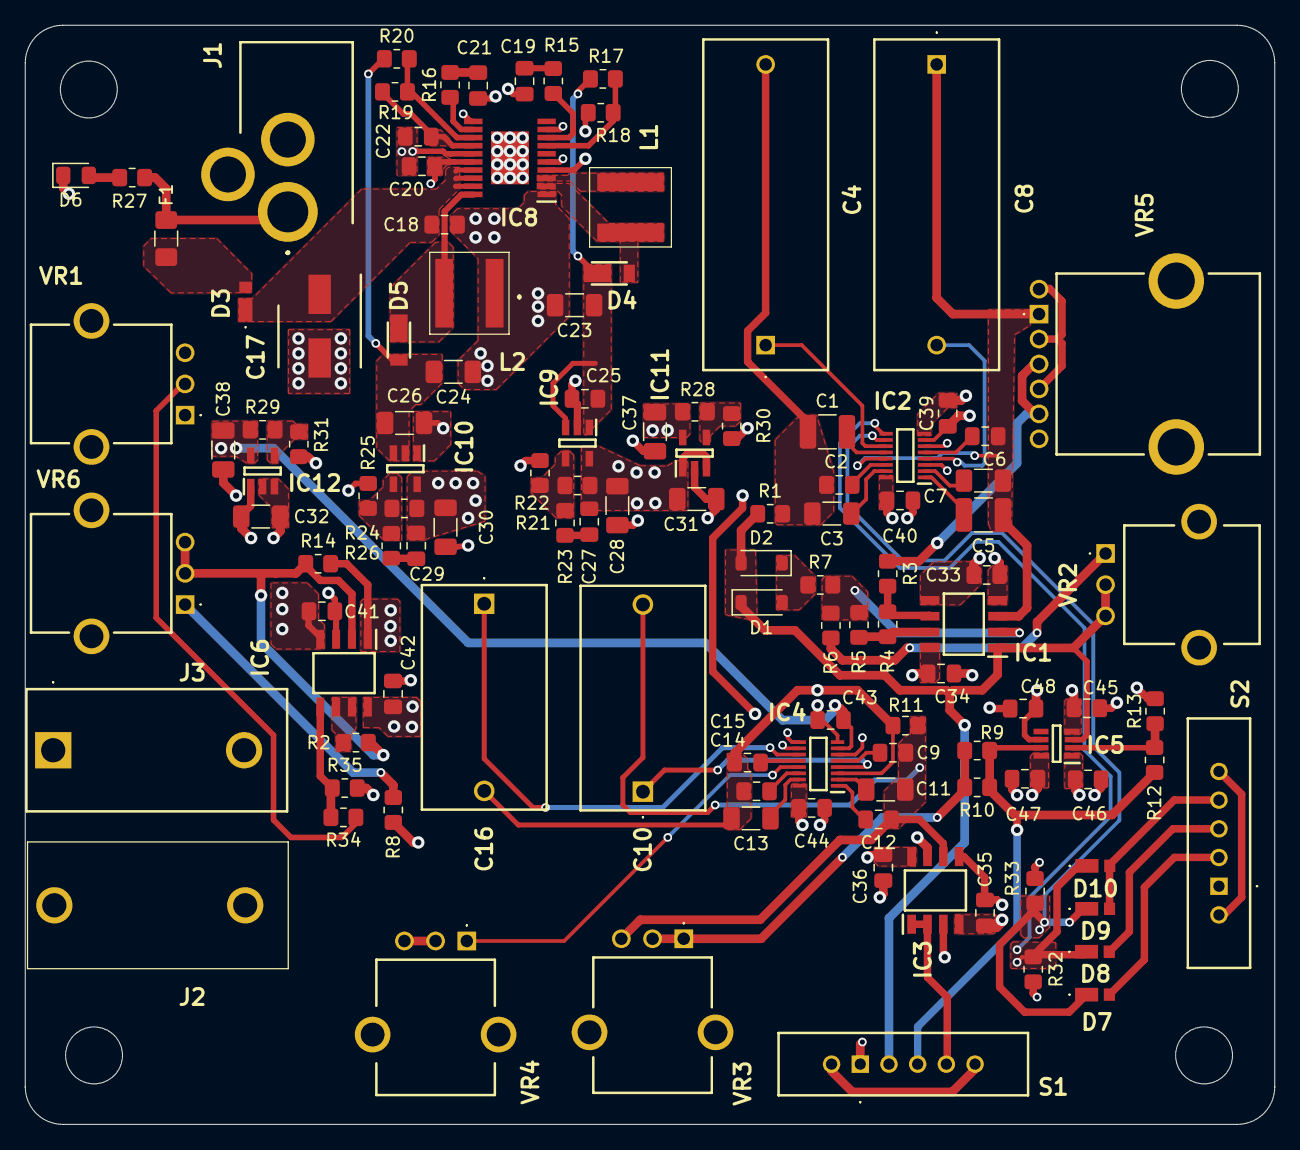
[picture p8: board function_generator.kicad_pcb from above]

Board: 4 copper layers, 100.2 x 88.1 mm, 118 parts (0 on the bottom side), 73 nets.
