DarqSh/kicad_function_generator/(commit log)

2026-10-31 Almost finished sketch
    [function_generator.kicad_pcb, function_generator.kicad_sch, scaling&offset.kicad_sch, sine_generator.kicad_sch, square+triangle_generator.kicad_sch, square_generator.kicad_sch, triangle_generator.kicad_sch]
2026-11-03 Lots of changes
    [frequency_range_select.kicad_sch, function_generator.kicad_pcb, function_generator.kicad_sch, power_supply.kicad_sch, scaling&offset.kicad_sch, shape_select.kicad_sch, sine_generator.kicad_sch, square_generator.kicad_sch]
2026-11-08 layout and routing complete
    [frequency_range_select.kicad_sch, function_generator.csv, function_generator.kicad_pcb, function_generator.kicad_sch, power_supply.kicad_sch, scaling&offset.kicad_sch, sine_generator.kicad_sch, square_generator.kicad_sch]
2026-11-08 Silkscreen fix
    [function_generator.kicad_pcb]
2026-11-08 Finish PCB
    [3dmodel2.step, bom.csv, designators.csv, frequency_range_select.kicad_sch, function_generator.kicad_pcb, function_generator.kicad_sch, positions.csv, power_supply.kicad_sch]
2026-11-08 Add production files+lib fix
    [bom.csv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]
2026-11-08 Slight position change + create Gerbers
    [function_generator-B_Cu.gbl, function_generator-B_Mask.gbs, function_generator-B_Paste.gbp, function_generator-B_Silkscreen.gbo, function_generator-Edge_Cuts.gm1, function_generator-F_Cu.gtl, function_generator-F_Mask.gts, function_generator-F_Paste.gtp]
2026-11-08 Add updated 3d model
    [function_generator.kicad_pcb, function_generator.step]
2026-11-09 Update silkscreen + production files
    [function_generator.kicad_pcb]
2026-11-10 Update silkscreen v2 + production files
    [function_generator.kicad_pcb]
